NguyenCongChinh28/DATN_CHUONG_BAO_CHAY/01.Docs/sx126xdriver_1_/SX126xDriver/platform/platform_common/README.docx

Common常用功能说明

修改记录

类型 | 修改内容 | 修改人 | 日期 | 软件版本
A | 初稿版本 | 杨宾 | 2018/09/06 | V0.0.0
M | 增加AT_SERVICE_BUFLEN的默认设置，修改了目录结构 | 杨宾 | 2019/01/16 | V0.0.1

类型：A-新增 M-修改 D-删除

目录

# 1. 更新记录

V0.0.0 初始版本

V0.0.1 头文件中增加AT_SERVICE_BUFLEN的默认设置，修改了目录结构

# 2. 功能描述

## 2.1 提供以下几个打印接口(用法和printf相同)

DEBUG()

ERROR_LOG()

AT_PRINT()

## 2.2 规定了一些常见返回值的枚举类型

定义了常见返回值

common_ret

这样可以方便统一返回值的含义

## 2.3 根据结构体成员地址获取结构体的地址

list_entry()可以根据一个结构体成员的地址计算出整个结构体的地址

# 3. 使用限制

在没有调度系统的前后台程序中可以正常使用，理论上多任务系统也可以正常使用（未验证）

# 4. 移植方法

## 4.1 拷贝文件

将common整个目录拷贝到目标工程的合适目录

## 4.2 配置工程

修改工程，添加源码和头文件引用路径

## 4.3 补充project_config.h

project_config.h这个文件是作为目标工程整个工程的一个整体配置文件（以后自己所有新添加的框架都可以把一些经常会修改的宏一起放在这里），在这个文件中可以添加一些默认设置，如果没有那么框架会使用默认值（设置后就会使用这个文件中的值）

参考 附录1

## 4.4 完成中间件处理

common_API.c和common_API.h是用来适配不同硬件的中间件，不同平台的数据类型和函数接口在这里进行统一(comon框架暂时没有涉及特殊数据类型，这个暂时不用适配)

# 附录：

## 1. 参考project_config.h

#ifndef __PROJECT_CONFIG_H__

#define __PROJECT_CONFIG_H__

/*-------------common 框架相关配置----------------------------*/

#define ENABLE_DEBUG 1 //使能 DEBUG 接口

#define ENABLE_INFO_LOG 1 //使能 ERROR_LOG 接口

#define AT_SERVICE_BUFLEN 512 //tmp_print_buf打印buf大小

#define ENABLE_INFO_LOG 1 //使能 AT_PRINT 接口

#endif /*end of __PROJECT_CONFIG_H__*/

2. 的
