NguyenCongChinh28/DATN_CHUONG_BAO_CHAY/01.Docs/Test case.xlsx

Test case LoRa | Pass | Chú ý
Ấn nút điều khiển relay | Relay nháy, phát ra tiếng kêu Đèn led nháy | Đo tiếp điểm relay
Gạt nút manual | Relay nháy, phát ra tiếng kêu Đèn led nháy | Đo tiếp điểm relay
Ấn nút pair | Đèn nháy
