NguyenCongChinh28/DATN_CHUONG_BAO_CHAY/hardware_update/BST_SLAVE_A00 - Copy.pdf

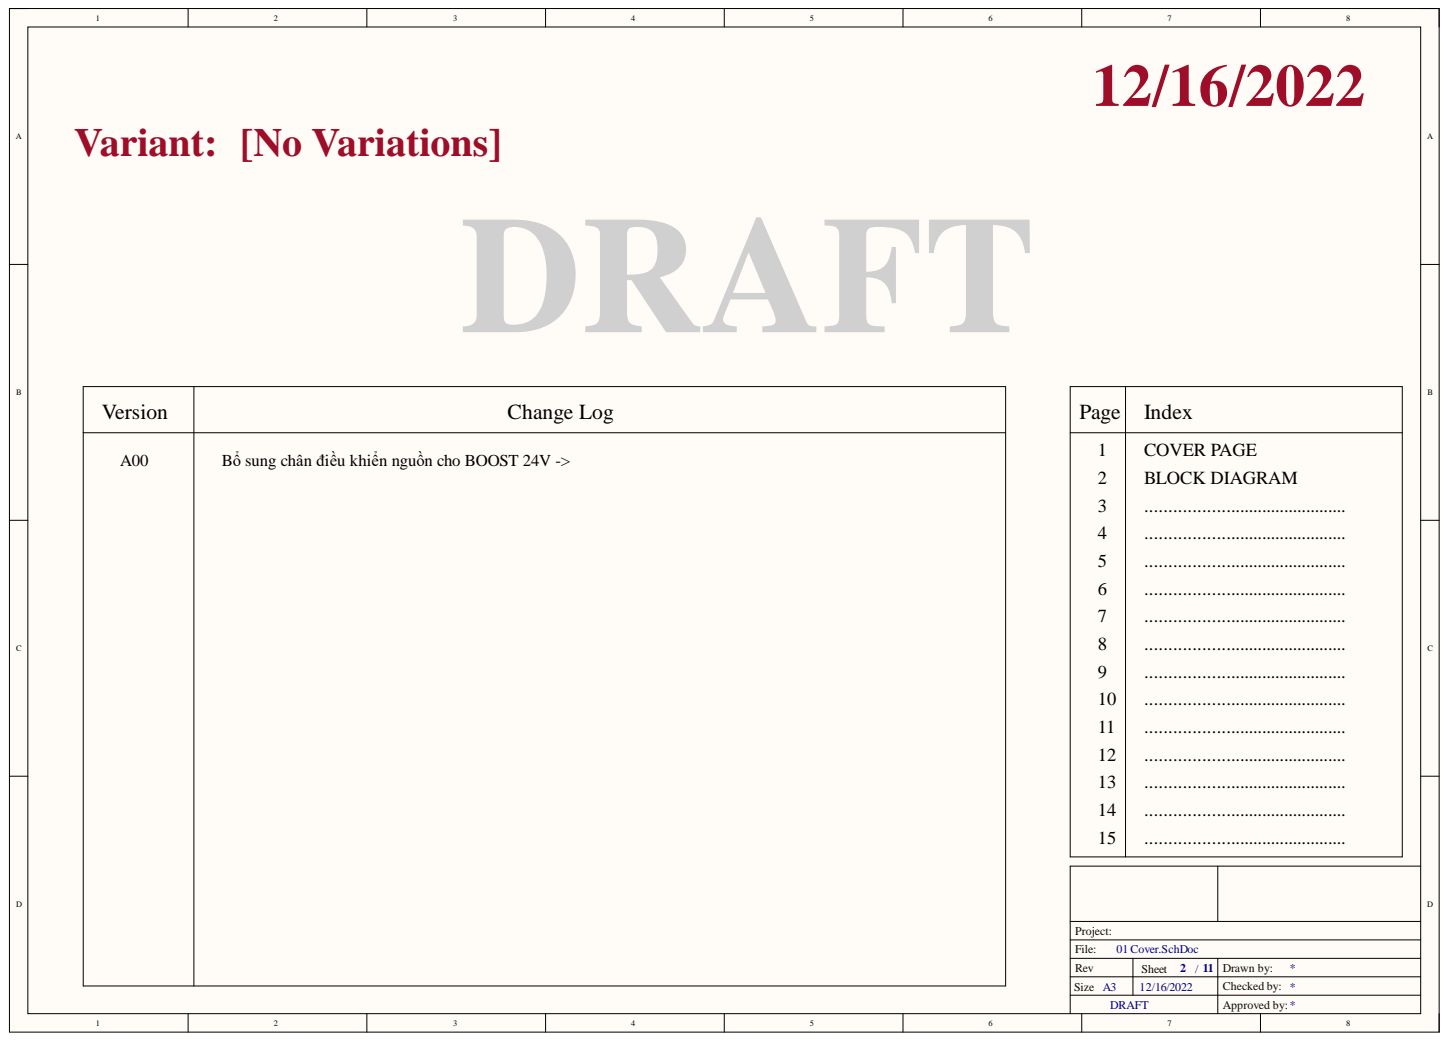
[picture p1: page 1]

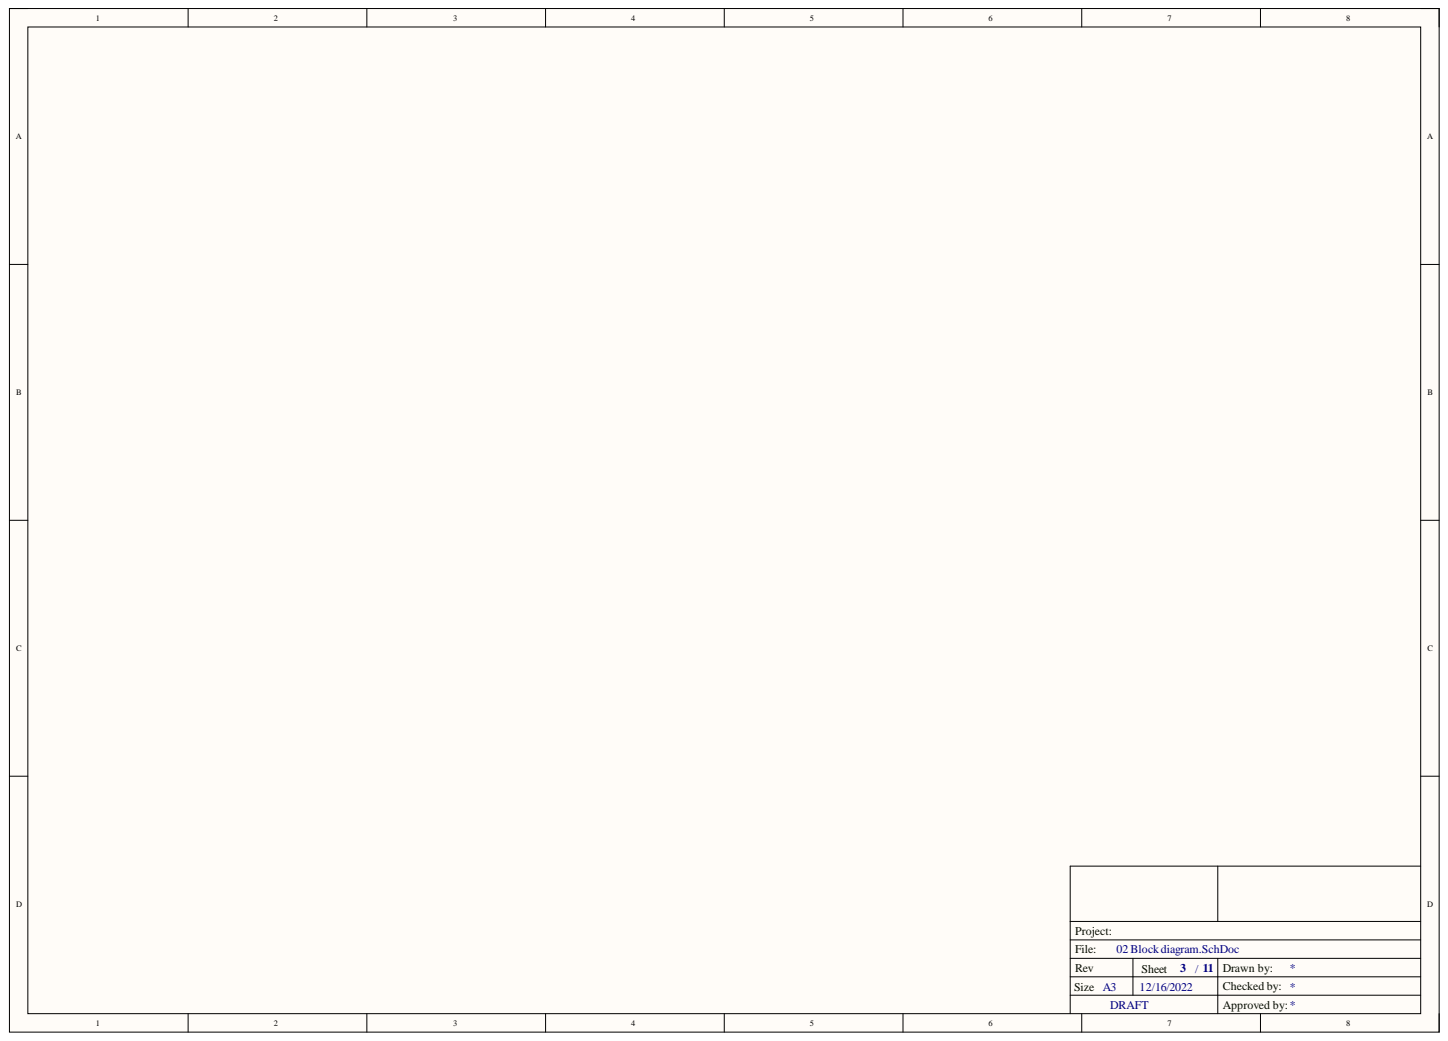
[picture p2: page 2]

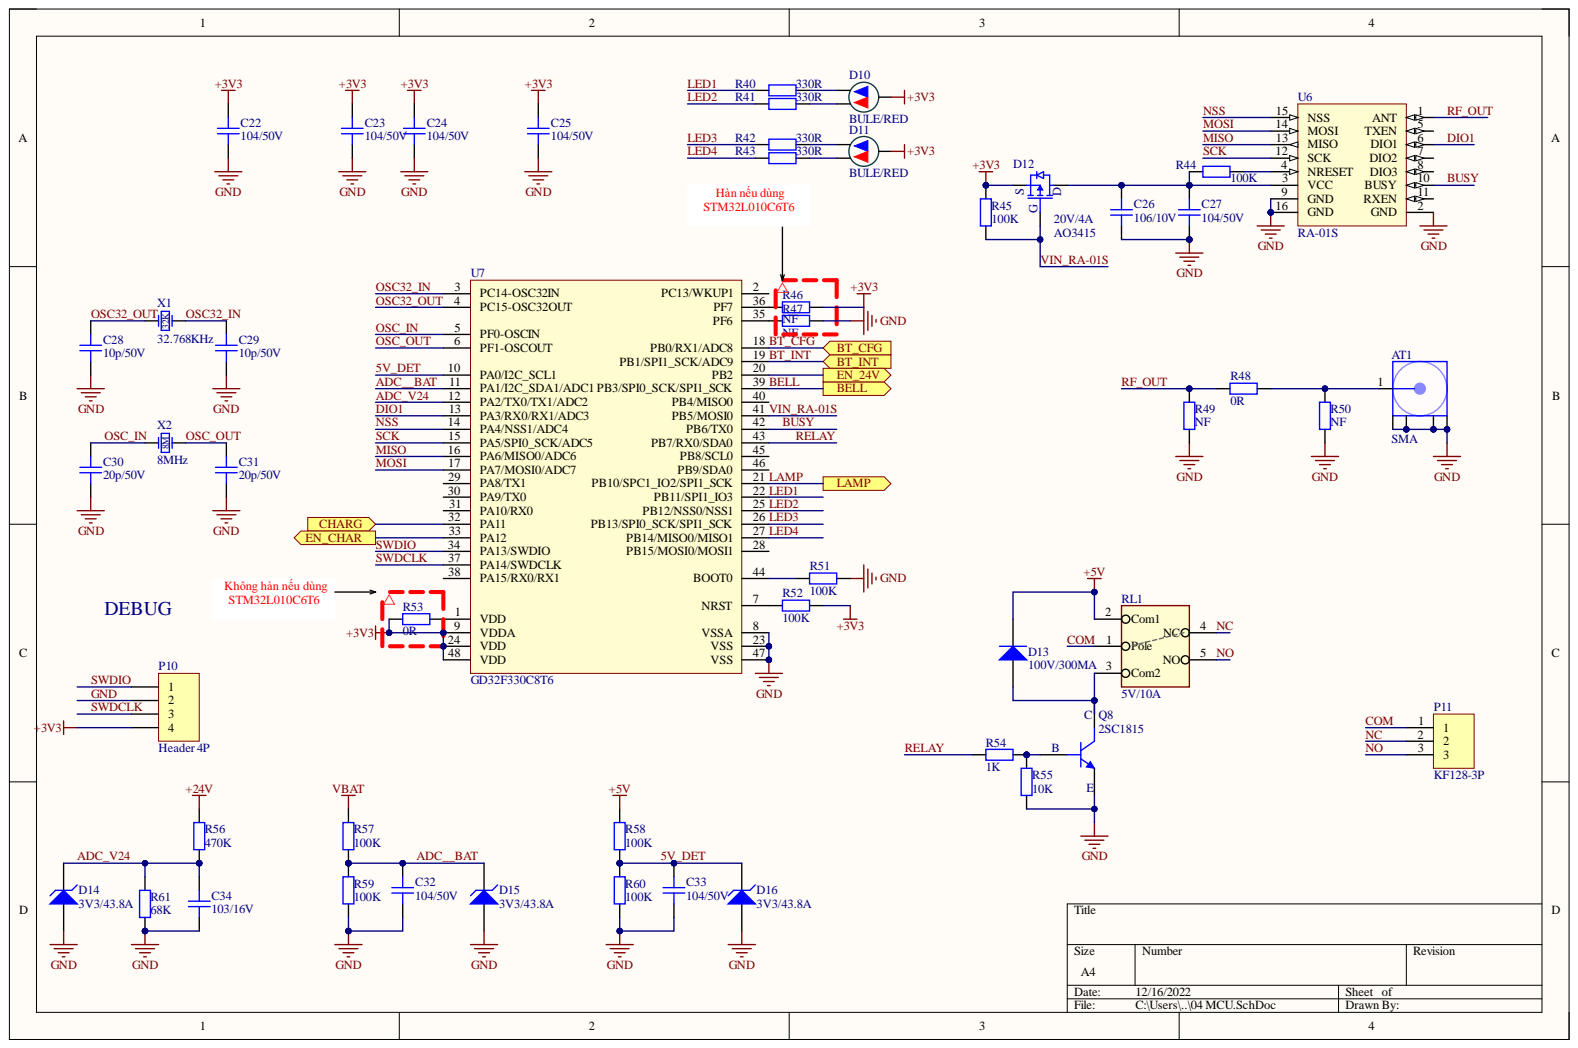
[picture p3: page 3]

S i z e A4 | Numb e r | R e vision

Date : 12/16/20 2 2 | She et of
F ile : C :\Use rs\. .\04 MC U . S chDoc | Dr awn By:

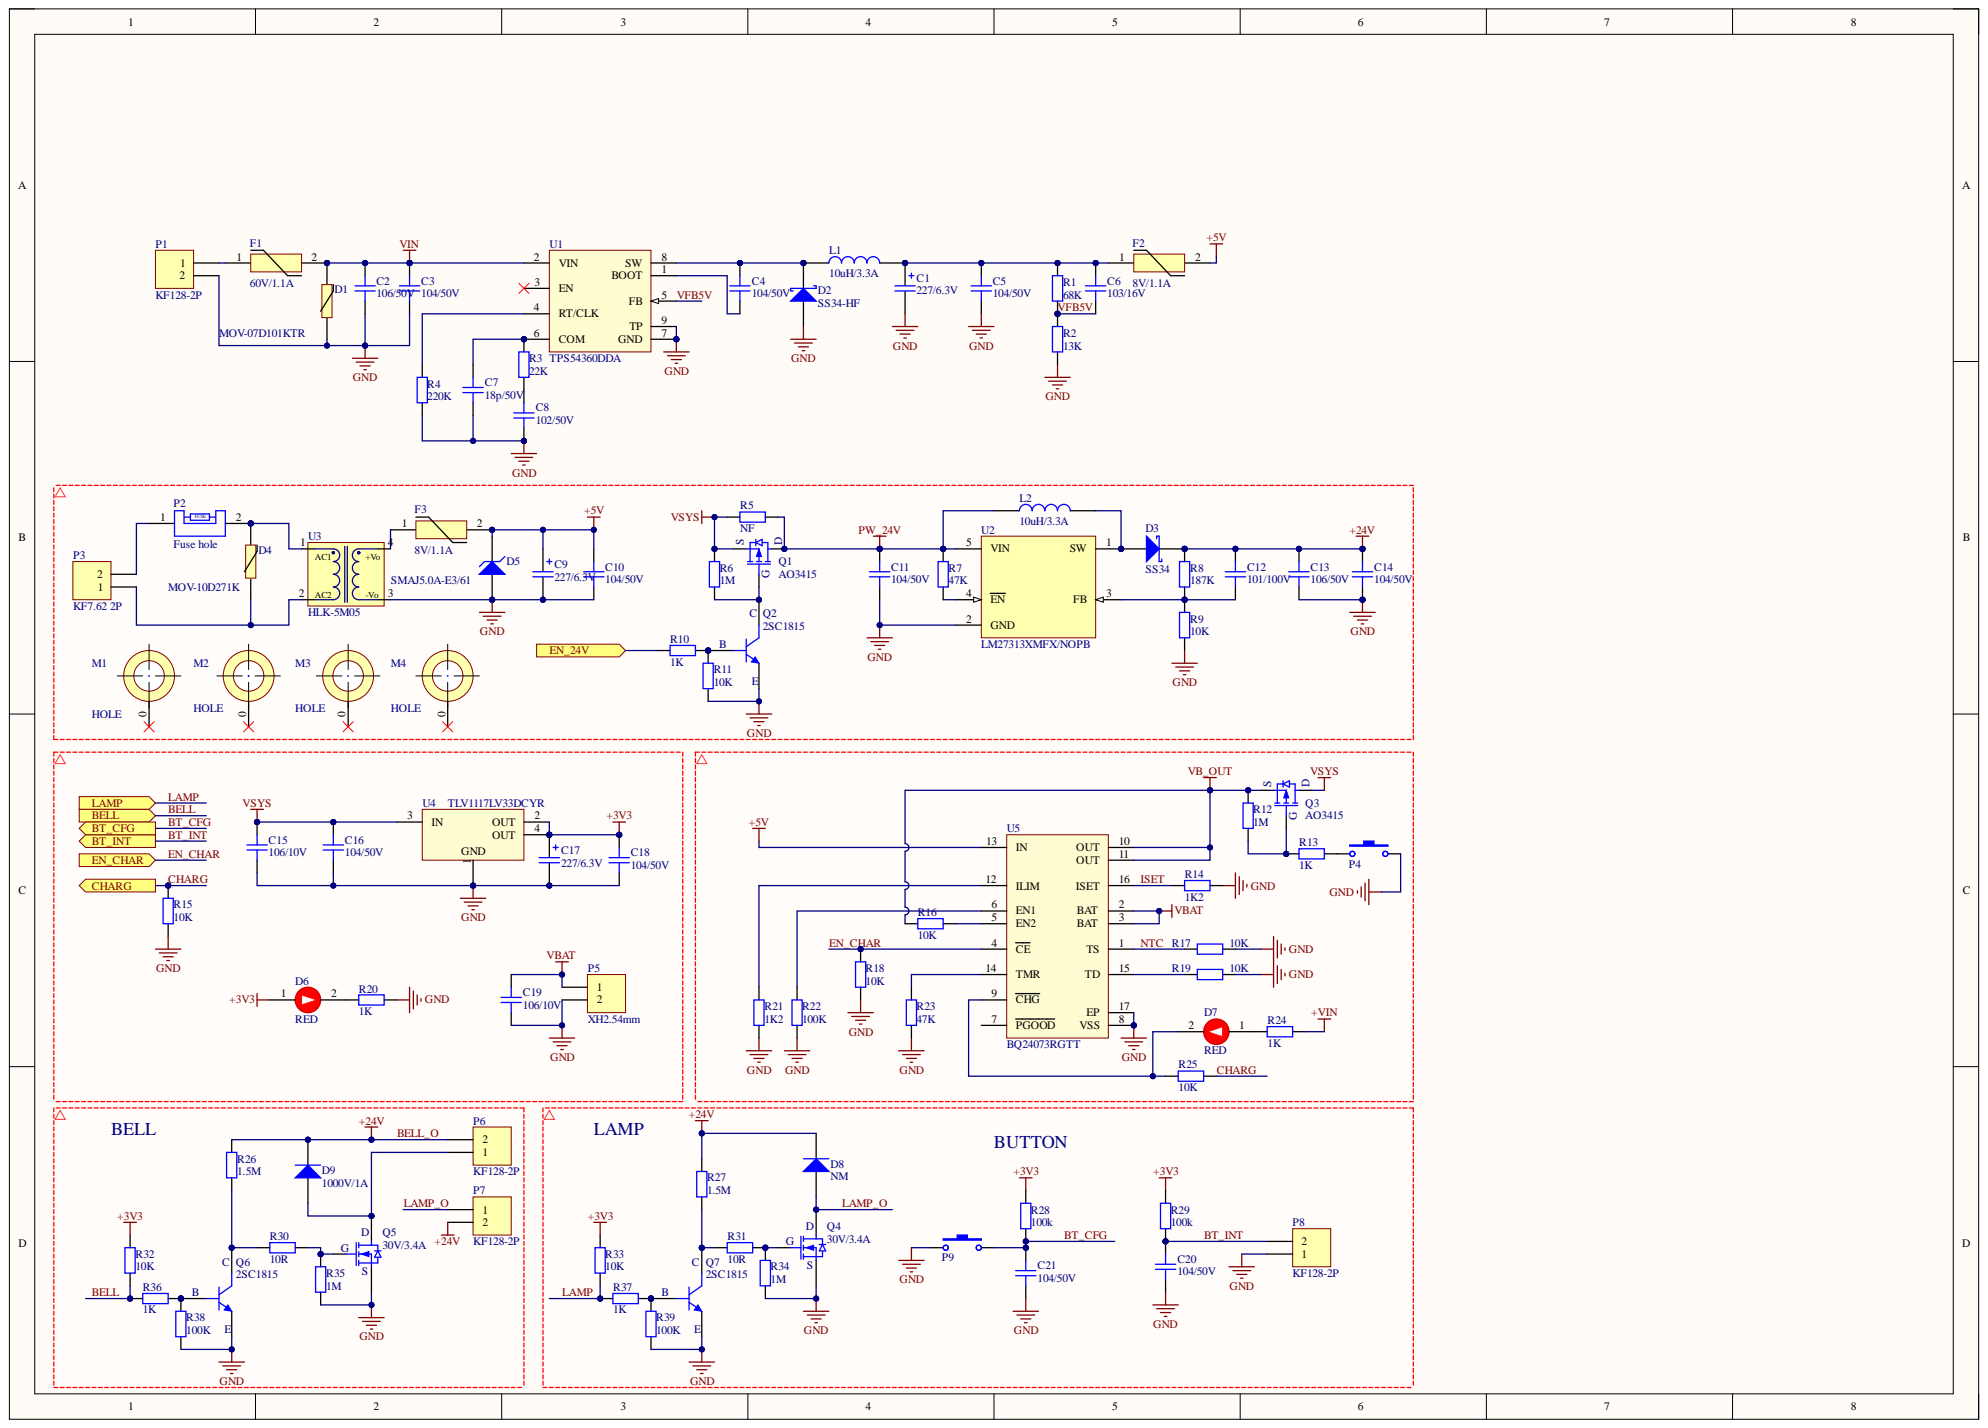
[picture p4: page 4]

GND 2

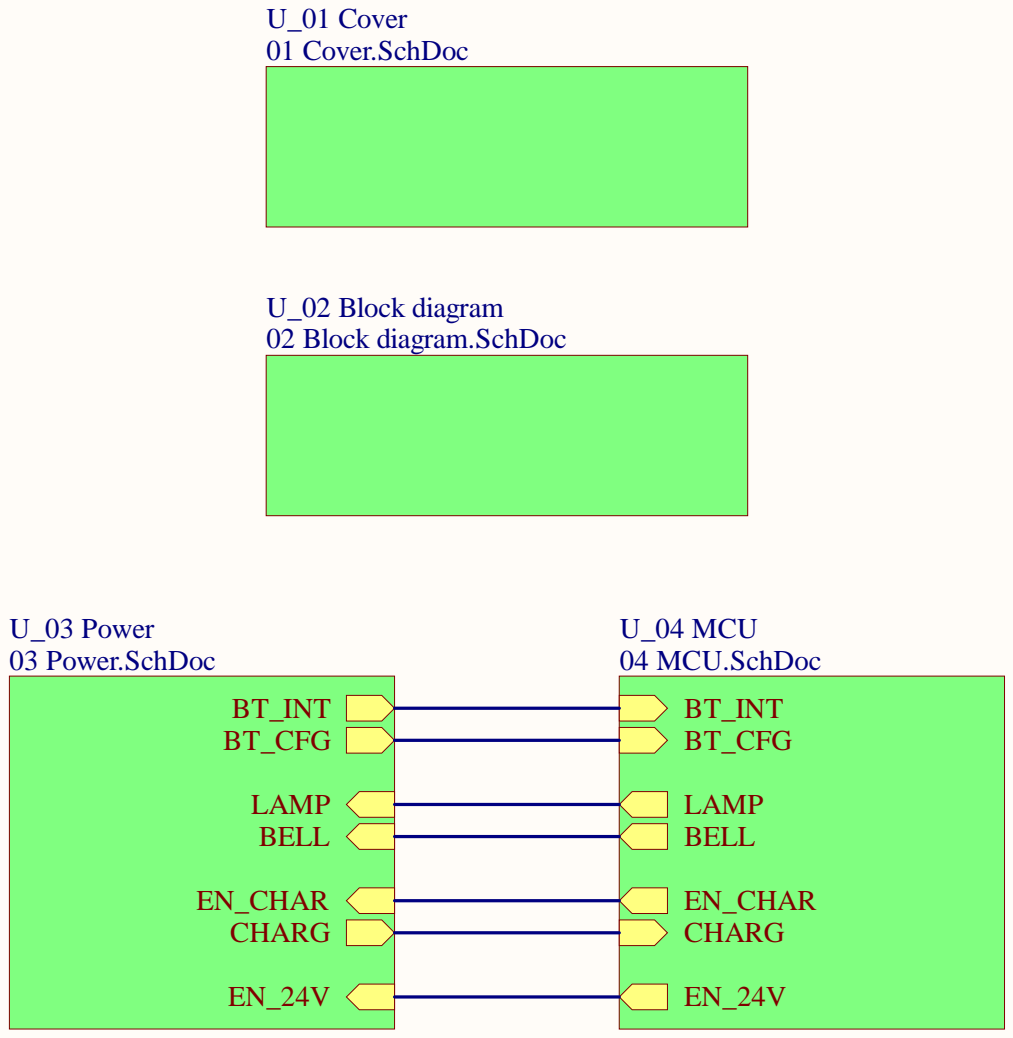
[picture p5: page 5]

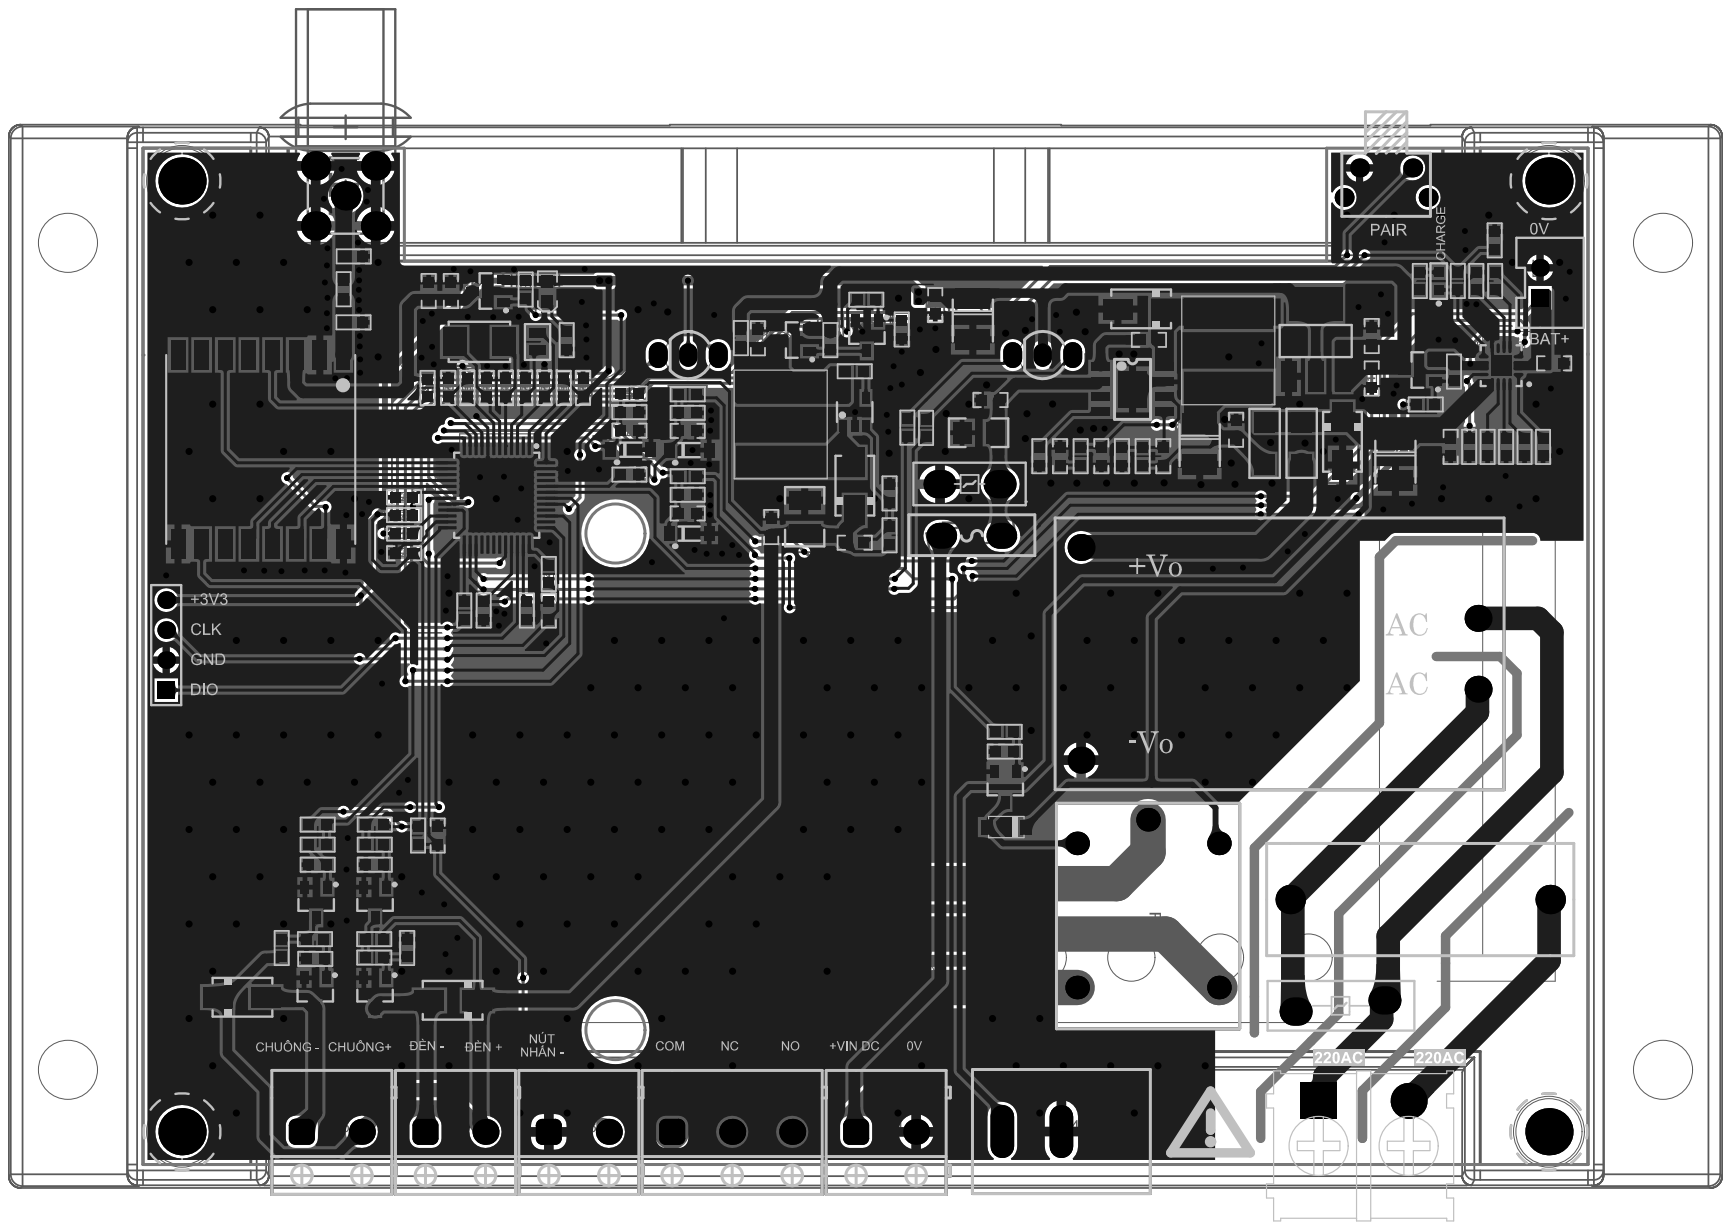
[picture p6: page 6]

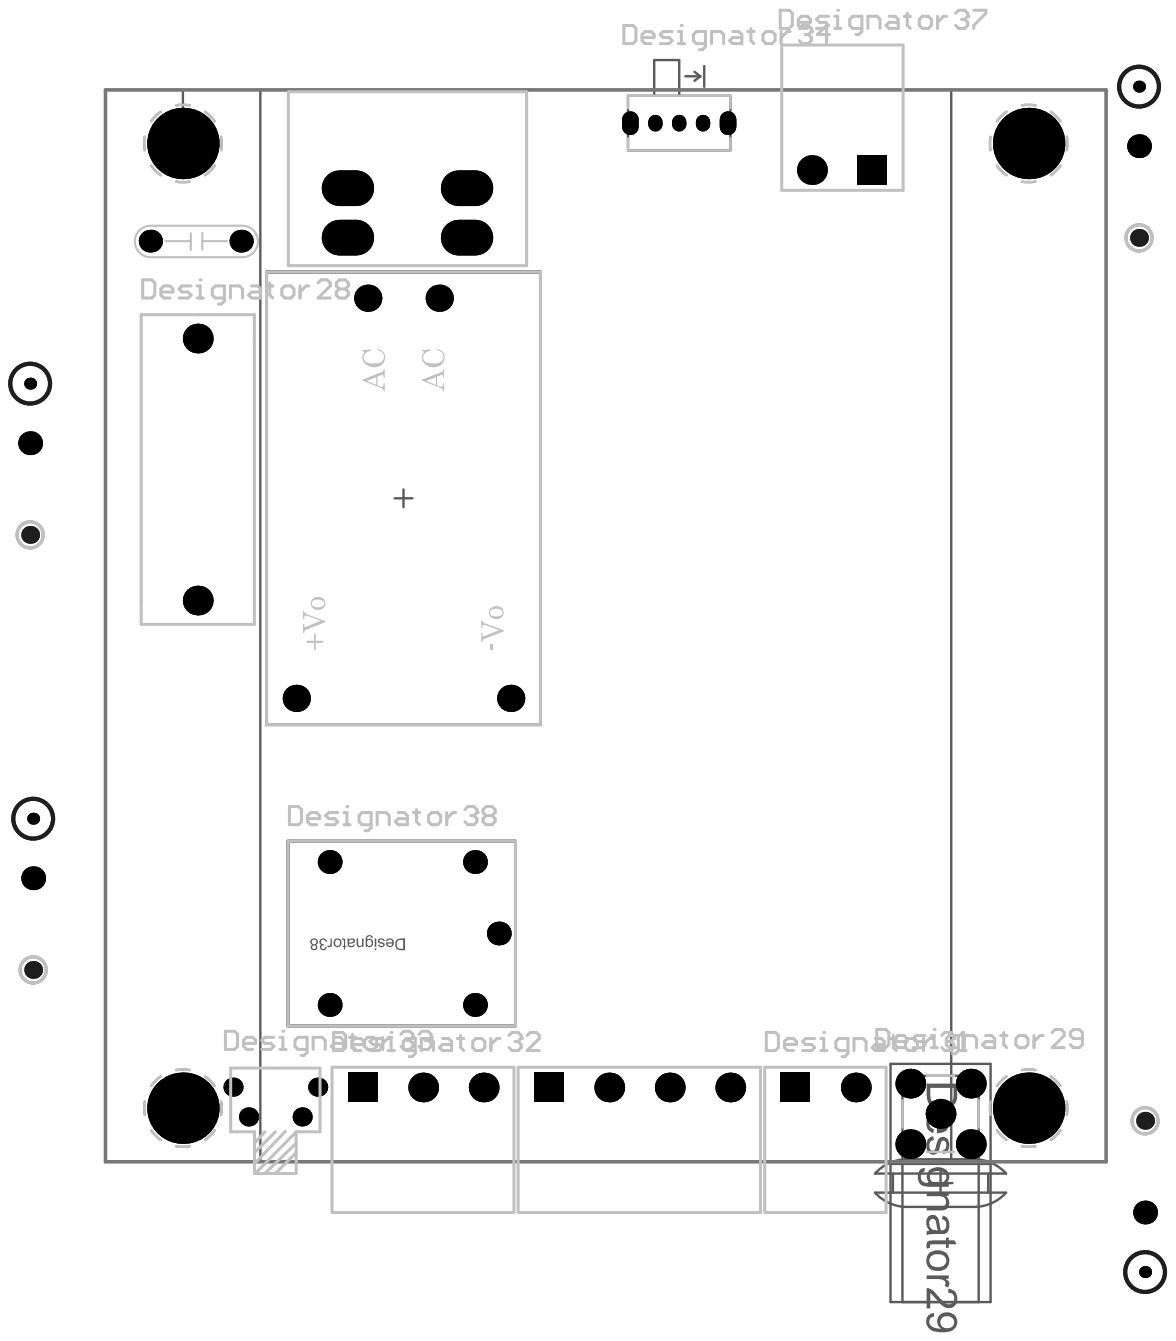
[picture p7: page 7]

Comment | Description | Designator | Footprint | LibRef | Quantity
SMA | | AT1 | SMA-KWE-17-V1 | GKZS-SMAJZM-KWE-17.3 | | 1
227/6.3V | CAP TANT POLY 220uF 20% 6.3V 3528 35mOhm ESR | C1, C9, C17 | CAP_TANTAL_1210(3 528) | T520B227M006ATE03 5 | | 3
106/50V | CAP CER 10UF 50V X7R 1206 | C2 | CAPC-1206 (3216) | CL31B106KBHNNNE | | 1
104/50V | CAP CER 0.1uF 50V 10% X7R 0603 | C3, C4, C5, C10, C11, C14, C16, C18, C20, C21, C22, C23, C24, C25, C27, C32, C33 | CAPC-0603 (1608) -HD | C0603C104K5RACTU | 17
103/16V | CAP CER 10nF 16V 10% X7R 0603 | C6, C34 | CAPC-0603 (1608) -HD | CC0603KRX7R7BB103 | | 2
18p/50V | CAP CER 18pF 5% 50V C0G/NP0 0603 | C7 | CAPC-0603 (1608) -HD | CL10C180JB8NNNC | | 1
102/50V | CAP CER 1nF 50V 10% X7R 0603 | C8 | CAPC-0603 (1608) -HD | C0603C102K5RACTU | | 1
101/100V | CAP CER 100PF 100V C0G/NP0 0603 | C12 | CAPC-0603 (1608) -HD | CL10C101JC8NNNC | | 1
106/50V | CAP CER 10uF 10% 50V X7R 1210 (3255) | C13 | CAPC-1210 (3225) | GRM32ER71H106KA12 L | | 1
106/10V | CAP CER 10uF 10% 10V X5R 0603 | C15, C19, C26 | CAPC-0603 (1608) -HD | CL10A106KP8NNNC | | 3
10p/50V | CAP CER 10PF 50V NP0 0603 | C28, C29 | CAPC-0603 (1608) -HD | CL10C100JB8NNND | | 2
20p/50V | CAP CER 20pF 5% 50V C0G/NP0 0603 | C30, C31 | CAPC-0603 (1608) -HD | CL10C200JB8NNNC | | 2
MOV-07D101KTR | VARISTOR 100V 1.2KA DISC 7MM | D1 | MOV-07D101KTR | MOV-07D101KTR | | 1
SS34-HF | DIODE SCHOTTKY 40V 3A SMA | D2 | DIODE_DO214AC_SM A | SS34-HF | | 1
SS34 | DIODE SCHOTTKY 40V 3A SMA | D3 | DIODE_DO214AC_SM A | SS34 | | 1
MOV-10D271K | Varistors 370pF 270volts 10% | D4 | MOV-10D271K | MOV-10D271K | | 1
SMAJ5.0A-E3/61 | DIODE TVS 5VWM 9.2VC SMA | D5 | DIODE_DO214AC_SM A | SMAJ5.0A-E3/61 | | 1
RED | LED RED 0603 SMD | D6 | LED_0603_RED | LED RED 0603 | | 1
RED | LED 0603 RED | D7 | LED 0603 | LED 0603 RED | | 1
NM | DIODE GEN PURP 1KV 1A SMA | D8 | DIODE_DO214AC_SM A | 1N4007_SMA | | 1
1000V/1A | DIODE GEN PURP 1KV 1A SMA | D9 | DIODE_DO214AC_SM A | 1N4007_SMA | | 1
BULE/RED | LED DUAL COLOR BLUE/RED 3MM COMMON ANODE | D10, D11 | LED_3MM_DUALCOL OR | LED BLUE/RED 3MM | | 2
20V/4A | MOSFET P-CH 20V 4A SOT23 | D12 | SOT23_3 | AO3415 | | 1
100V/300MA | DIODE GEN PURP 100V 300MA SOD123 | D13 | SOD-123 | 1N4148-W-7 | | 1
3V3/43.8A | TVS DIODE 3.3VWM 8VC CFP3 | D14, D15, D16 | SOD123 | PTVS3V3S1UR,115 | | 3
60V/1.1A | PTC RESET FUSE 60V 1.1A RADIAL | F1 | FUSE-RUEF300 | RKEF110 | | 1
8V/1.1A | FUSE PTC RESET 8V 1.10A 1206 | F2, F3 | FUSE_1206(3216) | 1206L110THYR | | 2
10uH/3.3A | FIXED IND 10UH 3.3A 38 MOHM SMD | L1, L2 | IND-74404084150 | SWPA8040S100MT | | 2
KF128-2P | KF128-2P 5.08MM | P1, P6, P7, P8 | KF128 - 2P 5.08MM | KF128-2P 5.08MM | | 4
Fuse hole | Fuse Holders ROHS | P2 | FUSE SOKCET | C3131 | | 1
KF7.62 2P | Header, 2-Pin, pitch 5.08mm | P3 | KF7.62_2P | KF7.62 2P | | 1
KCD11 | Switch ON OFF | P4 | KCD11 | KCD11 | | 1
XH2.54mm | XH2.54mmm - 2P 180 degree | P5 | XH2.54-2P | XH2.54-2P | | 1
Button | Button 6x6xH (H=4.3~13mm) | P9 | KFC-A06W1-6 | KFC-A06W1-H | | 1
Header 4P | Header, 4 Pin Pitch 2.54mm | P10 | HDR1X4 | Header 4x1 | | 1
KF128-3P | KF128-3P 5.08MM | P11 | KF128 - 3P 5.08MM | KF128-3P 5.08MM | | 1
AO3415 | MOSFET P-CH 20V 3.7A SOT-23 | Q1, Q3 | SOT23_3 | IRLML6402TRPBF | | 2
2SC1815 | TRANS NPN 50V 0.15A SOT23-3 | Q2, Q6, Q7, Q8 | SOT23_3 | 2SC1815 | | 4
30V/3.4A | MOSFET N-CH 30V 3.4A SOT23 | Q4, Q5 | SOT23_3 | IRLML6346TRPBF | | 2
68K | RES SMD 68K OHM 1% 1/10W 0603 | R1, R61 | RESC-0603 (1608) - HD CRCW060368K0FKEA | | | 2
13K | RES SMD 13K OHM 1% 1/10W 0603 | R2 | RESC-0603 (1608) - HD AC0603FR-0713KL | | | 1
22K | RES SMD 22K OHM 1% 1/10W 0603 | R3 | RESC-0603 (1608) - HD RC0603FR-0722KL | | | 1
220K | RES SMD 220K OHM 1% 1/10W 0603 | R4 | RESC-0603 (1608) - HD RC0603FR-07220KL | | | 1
NF | RES SMD 0.0OHM JUMPER 1/10W 0603 | R5, R46, R47, R49, R50 RESC-0603 (1608) - HD RC0603FR-070RL | | | | 5
1M | RES SMD 1M OHM 1% 1/10W 0603 | R6, R12, R34, R35 | RESC-0603 (1608) - HD CRCW06031M00FKEA | | | 4
47K | RES SMD 47K OHM 1% 1/10W 0603 | R7, R23 | RESC-0603 (1608) - HD RC0603FR0747KL | | | 2
187K | RES SMD 150K OHM 1% 1/10W 0603 | R8 | RESC-0603 (1608) - HD RC0603FR-07187KL | | | 1
10K | RES SMD 10K OHM 1% 1/10W 0603, RES 10K OHM 1% 1/10W 0603 | R9, R11, R15, R16, R17, R18, R19, R25, R32, R33, R55 | RESC-0603 (1608) - HD RC0603FR-0710KL | | 11
1K | RES SMD 1 KOHM 1% 1/10W 0603 | R10, R13, R20, R24, R36, R37, R54 | RESC-0603 (1608) - HD RC0603FR-071KL | | | 7
1K2 | RES SMD 1.2K OHM 1% 1/10W 0603 | R14, R21 | RESC-0603 (1608) - HD RC0603FR-071K2L | | | 2
100K | RES SMD 100K OHM 1% 1/10W 0603 | R22, R28, R29, R38, R39, R44, R45, R51, R52, R57, R58, R59, R60 | RESC-0603 (1608) - HD RC0603FR-07100KL | | 13
1.5M | RES SMD 1.5M OHM 1% 1/10W 0603 | R26, R27 | RESC-0603 (1608) - HD RC0603FR-071M5L | | | 2
10R | RES SMD 10OHM 1% 1/10W 0603 | R30, R31 | RESC-0603 (1608) - HD RC0603FR-0710RL | | | 2
330R | RES SMD 330OHM 1% 1/10W 0603 | R40, R41, R42, R43 | RESC-0603 (1608) - HD RC0603FR-07330RL | | | 4
0R | JUMPER 1/10W 0603 RES SMD 0.0OHM | R48, R53 | RESC-0603 (1608) - HD RC0603FR-070RL | | | 2
470K | RES SMD 470K OHM 1% 1/10W 0603 | R56 | RESC-0603 (1608) - HD RC0603FR-07470KL | | | 1
5V/10A | SRD-05VDC-SL-C Relay 5V DC 10A 1 FORM C | RL1 | RELAY 5V | Relay 5V | | 1
TPS54360DDA | IC REG BCK SPLIT RAIL ADJ 8SOPWR | U1 | SOIC8 - TP | TPS54360DDAR | | 1
LM27313XMFX/NOPB | IC REG BOOST ADJ 800MA SOT23-5 | U2 | SOT23-5 | LM27313XMFX/NOPB | | 1
HLK-5M05 | Ultra-compact module power 5V/5W | U3 | HLK-5M12 | HLK-5M05 | | 1
TLV1117LV33DCYR | IC REG LINEAR 3.3V 1A SOT223-4 | U4 | SOT-223-4 | TLV1117LV33DCYR | | 1
BQ24073RGTT | IC LI-ION CHARGE/PWR MGMT 16-QFN | U5 | RGT16-1700X1700TP | BQ24073RGTT | | 1
RA-01S | Module lora RA-01S SX1268 | U6 | Lora1276 V1.2 | RA-01S | | 1
GD32F330C8T6 | ARM® Cortex®-M4 32-bit MCU 64K Flash 8K RAM | U7 | LQFP-48 | GD32F330C8T6 | | 1
32.768KHz | CRYSTAL 32.7680KHZ 4pF SMD | X1 | CRYSTAL_ABS06 2x1.2mm | ABS06-107-32.768kHz-T | | 1
8MHz | CRYSTAL 8.0000MHZ 18pF SMD | X2 | CRYSTAL_ABM3 5x3.2mm | ABM3-8.000MHZ-D2Y-T | | 1
