NguyenCongChinh28/DATN_CHUONG_BAO_CHAY/(list of files, drawings)

Other design files:
03.Hardware/Graduate_Project.PrjPCB
03.Hardware/New folder/Graduate_Project.PrjPCB
03.Hardware/New folder/SL_Block_Diagram_ver_1.6.SchDoc
03.Hardware/New folder/SL_LoRa_Schematic.SchDoc
03.Hardware/SL_Block_Diagram_ver_1.6.SchDoc
03.Hardware/SL_LoRa_Schematic.SchDoc
testlora/Lora/Graduate_Project.PrjPCB
testlora/Lora/SL_Block_Diagram_ver_1.6.SchDoc
testlora/Lora/SL_LoRa_Schematic.SchDoc
