NguyenCongChinh28/DATN_CHUONG_BAO_CHAY/DATN_SLAVE/STM32_Lora_BC/Core/Inc/main.h

#define BT_ALARM_Pin GPIO_PIN_1
#define BT_ALARM_GPIO_Port GPIOA
#define BT_PAIR_Pin GPIO_PIN_2
#define BT_PAIR_GPIO_Port GPIOA
#define LORA_SPI_CS_Pin GPIO_PIN_4
#define LORA_SPI_CS_GPIO_Port GPIOA
#define LORA_DIO1_ISR_Pin GPIO_PIN_4
#define LORA_DIO1_ISR_GPIO_Port GPIOC
#define LORA_DIO1_ISR_EXTI_IRQn EXTI4_IRQn
#define LORA_DIO2_Pin GPIO_PIN_5
#define LORA_DIO2_GPIO_Port GPIOC
#define LORA_DIO3_Pin GPIO_PIN_0
#define LORA_DIO3_GPIO_Port GPIOB
#define LORA_RESET_PIN_Pin GPIO_PIN_1
#define LORA_RESET_PIN_GPIO_Port GPIOB
#define LORA_BUSY_Pin GPIO_PIN_2
#define LORA_BUSY_GPIO_Port GPIOB
#define BUZZER_Pin GPIO_PIN_12
#define BUZZER_GPIO_Port GPIOB
