NguyenCongChinh28/DATN_CHUONG_BAO_CHAY/update2/02.Firmware/02.Firmware/stm32/BST01_Lamp_Button/Core/Src/app_spi.c

#include "app_spi.h"
#include "main.h"
#include "spi.h"

void app_spi_initialize(void)
{
    
}

void app_spi_tx(uint8_t *write_data, uint8_t *rx_dummy_data, uint32_t len)
{
    spi_tx(write_data, rx_dummy_data, len);
}

void app_spi_rx(uint8_t *rx_data, uint8_t *tx_dummy_data, uint32_t len)
{
    spi_rx(rx_data, tx_dummy_data, len);
}
