NguyenCongChinh28/DATN_CHUONG_BAO_CHAY/testlora/LoRa_Test-6b331992ed82af741d6343edfdcc3a34d70257da/Drivers/LoRa_Drivers/Devices/SX126X/src/sx126x-board.c

/*
  ______                              _
 / _____)             _              | |
( (____  _____ ____ _| |_ _____  ____| |__
 \____ \| ___ |    (_   _) ___ |/ ___)  _ \
 _____) ) ____| | | || |_| ____( (___| | | |
(______/|_____)_|_|_| \__)_____)\____)_| |_|
    (C)2013 Semtech

Description: SX126x driver specific target board functions implementation

License: Revised BSD License, see LICENSE.TXT file include in the project

Maintainer: Miguel Luis and Gregory Cristian
*/
//#include "stm32f10x.h"
#include "main.h"
#include "spi.h"
#include "my_delay.h"
#include "gpio.h"
//#include "HAL_SPI_API.h"
#include "radio.h"
#include "sx126x.h"
#include "sx126x-board.h"
//#include "common.h"



#define SPI_CSS_Pin_GPIO_Port			GPIOA
#define SPI_CSS_Pin_Pin					GPIO_PIN_4


#define	SX1278_RST_PIN_INDEX_GPIO_Port	GPIOA
#define	SX1278_RST_PIN_INDEX_GPIO_Pin   GPIO_PIN_11






uint8_t HALSpiInOut(SPI_HandleTypeDef *hspi, uint8_t transmitdata)
{
	uint8_t *data = &transmitdata;
	uint8_t receive_data = 0;
	HAL_SPI_TransmitReceive(hspi, data, &receive_data, 1, 200);
	return receive_data;
}




void SX126xReset( void )
{
    DelayMs( 1 );
    HAL_GPIO_WritePin(SX1278_RST_PIN_INDEX_GPIO_Port, SX1278_RST_PIN_INDEX_GPIO_Pin, GPIO_PIN_RESET);
    DelayMs( 2 );
    HAL_GPIO_WritePin(SX1278_RST_PIN_INDEX_GPIO_Port, SX1278_RST_PIN_INDEX_GPIO_Pin, GPIO_PIN_SET);
    DelayMs( 1);
}

void SX126xWaitOnBusy( void )
{
   while(HAL_GPIO_ReadPin(GPIOB, GPIO_PIN_2));
}


void SX126xWakeup( void )
{
    HAL_GPIO_WritePin( SPI_CSS_Pin_GPIO_Port, SPI_CSS_Pin_Pin,GPIO_PIN_RESET);
   
    HALSpiInOut(&hspi1,RADIO_GET_STATUS);
    HALSpiInOut(&hspi1,0);
    
    HAL_GPIO_WritePin( SPI_CSS_Pin_GPIO_Port, SPI_CSS_Pin_Pin,GPIO_PIN_SET);

    // Wait for chip to be ready.
    SX126xWaitOnBusy( );
}

void SX126xWriteCommand( RadioCommands_t command, uint8_t *buffer, uint16_t size )
{
	uint16_t i = 0;
    SX126xCheckDeviceReady( );

    HAL_GPIO_WritePin( SPI_CSS_Pin_GPIO_Port, SPI_CSS_Pin_Pin,GPIO_PIN_RESET);

    HALSpiInOut(&hspi1,( uint8_t )command );

    for( i = 0; i < size; i++ )
    {
        HALSpiInOut(&hspi1,buffer[i] );
    }

    HAL_GPIO_WritePin( SPI_CSS_Pin_GPIO_Port, SPI_CSS_Pin_Pin,GPIO_PIN_SET);
    
    if( command != RADIO_SET_SLEEP )
    {
        SX126xWaitOnBusy( );
    }
}

void SX126xReadCommand( RadioCommands_t command, uint8_t *buffer, uint16_t size )
{
	uint16_t i = 0;
    SX126xCheckDeviceReady( );

    HAL_GPIO_WritePin( SPI_CSS_Pin_GPIO_Port, SPI_CSS_Pin_Pin,GPIO_PIN_RESET);

    HALSpiInOut(&hspi1,( uint8_t )command );
    HALSpiInOut(&hspi1,0x00 );
    for( i = 0; i < size; i++ )
    {
        buffer[i] = HALSpiInOut(&hspi1,0 );
    }

    HAL_GPIO_WritePin( SPI_CSS_Pin_GPIO_Port, SPI_CSS_Pin_Pin,GPIO_PIN_SET);

    SX126xWaitOnBusy( );
}

void SX126xWriteRegisters( uint16_t address, uint8_t *buffer, uint16_t size )
{
	uint16_t i = 0;
	
    SX126xCheckDeviceReady( );

    HAL_GPIO_WritePin( SPI_CSS_Pin_GPIO_Port, SPI_CSS_Pin_Pin,GPIO_PIN_RESET);
    
    HALSpiInOut(&hspi1,RADIO_WRITE_REGISTER );
    HALSpiInOut(&hspi1,( address & 0xFF00 ) >> 8 );
    HALSpiInOut(&hspi1, address & 0x00FF );
    
    for( i = 0; i < size; i++ )
    {
        HALSpiInOut(&hspi1,buffer[i] );
    }


    HAL_GPIO_WritePin( SPI_CSS_Pin_GPIO_Port, SPI_CSS_Pin_Pin,GPIO_PIN_SET);

    SX126xWaitOnBusy( );
}

void SX126xWriteRegister( uint16_t address, uint8_t value )
{
    SX126xWriteRegisters( address, &value, 1 );
}

void SX126xReadRegisters( uint16_t address, uint8_t *buffer, uint16_t size )
{
	uint16_t i = 0;
    SX126xCheckDeviceReady( );

    HAL_GPIO_WritePin( SPI_CSS_Pin_GPIO_Port, SPI_CSS_Pin_Pin,GPIO_PIN_RESET);

    HALSpiInOut(&hspi1,RADIO_READ_REGISTER );
    HALSpiInOut(&hspi1,( address & 0xFF00 ) >> 8 );
    HALSpiInOut(&hspi1, address & 0x00FF );
    HALSpiInOut(&hspi1, 0 );
    for( i = 0; i < size; i++ )
    {
        buffer[i] = HALSpiInOut(&hspi1,0 );
    }

    HAL_GPIO_WritePin( SPI_CSS_Pin_GPIO_Port, SPI_CSS_Pin_Pin,GPIO_PIN_SET);

    SX126xWaitOnBusy( );
}

uint8_t SX126xReadRegister( uint16_t address )
{
    uint8_t data;
    SX126xReadRegisters( address, &data, 1 );
    return data;
}

void SX126xWriteBuffer( uint8_t offset, uint8_t *buffer, uint8_t size )
{
	uint16_t i = 0;
    SX126xCheckDeviceReady( );

    HAL_GPIO_WritePin( SPI_CSS_Pin_GPIO_Port, SPI_CSS_Pin_Pin,GPIO_PIN_RESET);
    
    HALSpiInOut(&hspi1, RADIO_WRITE_BUFFER );
    HALSpiInOut(&hspi1, offset );
    for( i = 0; i < size; i++ )
    {
        HALSpiInOut(&hspi1, buffer[i] );
    }

    HAL_GPIO_WritePin( SPI_CSS_Pin_GPIO_Port, SPI_CSS_Pin_Pin,GPIO_PIN_SET);

    SX126xWaitOnBusy( );
}

void SX126xReadBuffer( uint8_t offset, uint8_t *buffer, uint8_t size )
{
	uint16_t i = 0;
	
    SX126xCheckDeviceReady( );

    HAL_GPIO_WritePin( SPI_CSS_Pin_GPIO_Port, SPI_CSS_Pin_Pin,GPIO_PIN_RESET);

    HALSpiInOut(&hspi1,  RADIO_READ_BUFFER );
    HALSpiInOut(&hspi1,  offset );
    HALSpiInOut(&hspi1,  0 );
    for( i = 0; i < size; i++ )
    {
        buffer[i] = HALSpiInOut(&hspi1, 0 );
    }

    HAL_GPIO_WritePin( SPI_CSS_Pin_GPIO_Port, SPI_CSS_Pin_Pin,GPIO_PIN_SET);
    
    SX126xWaitOnBusy( );
}

void SX126xSetRfTxPower( int8_t power )
{
    SX126xSetTxParams( power, RADIO_RAMP_40_US );
}

uint8_t SX126xGetPaSelect( uint32_t channel )
{
//    if( GpioRead( &DeviceSel ) == 1 )
//    {
//        return SX1261;
//    }
//    else
//    {
//        return SX1262;
//    }
  
  return SX1262;
}

void SX126xAntSwOn( void )
{
    //GpioInit( &AntPow, ANT_SWITCH_POWER, PIN_OUTPUT, PIN_PUSH_PULL, PIN_PULL_UP, 1 );
}

void SX126xAntSwOff( void )
{
   // GpioInit( &AntPow, ANT_SWITCH_POWER, PIN_ANALOGIC, PIN_PUSH_PULL, PIN_NO_PULL, 0 );
}

bool SX126xCheckRfFrequency( uint32_t frequency )
{
    // Implement check. Currently all frequencies are supported
    return true;
}
