NguyenCongChinh28/DATN_CHUONG_BAO_CHAY/testlora/LoRa_Test-6b331992ed82af741d6343edfdcc3a34d70257da/Drivers/LoRa_Drivers/Aloha_Protocol/Config.h

/*
 * Config.h
 *
 *  Created on: Nov 18, 2021
 *      Author: Admin
 */

#ifndef LORA_DRIVERS_ALOHA_PROTOCOL_CONFIG_H_
#define LORA_DRIVERS_ALOHA_PROTOCOL_CONFIG_H_


#include "Layer1.h"
#include "Types.h"





#define MAXNODES			5

#define NODEID  	2u





#endif /* LORA_DRIVERS_ALOHA_PROTOCOL_CONFIG_H_ */
