NguyenCongChinh28/DATN_CHUONG_BAO_CHAY/(notices)

Notices in the files:
DATN_SLAVE/STM32_Lora_BC/Core/Inc/main.h:
Copyright (c) 2023 STMicroelectronics.
All rights reserved.
This software is licensed under terms that can be found in the LICENSE file
02.Firmware/stm32/BST01_Lamp_Button/Core/Src/spi.c:
Copyright (c) 2022 STMicroelectronics.
